zach-seletsky/ECE4180B-FinalProject/pictures/IMG_3392.jpeg

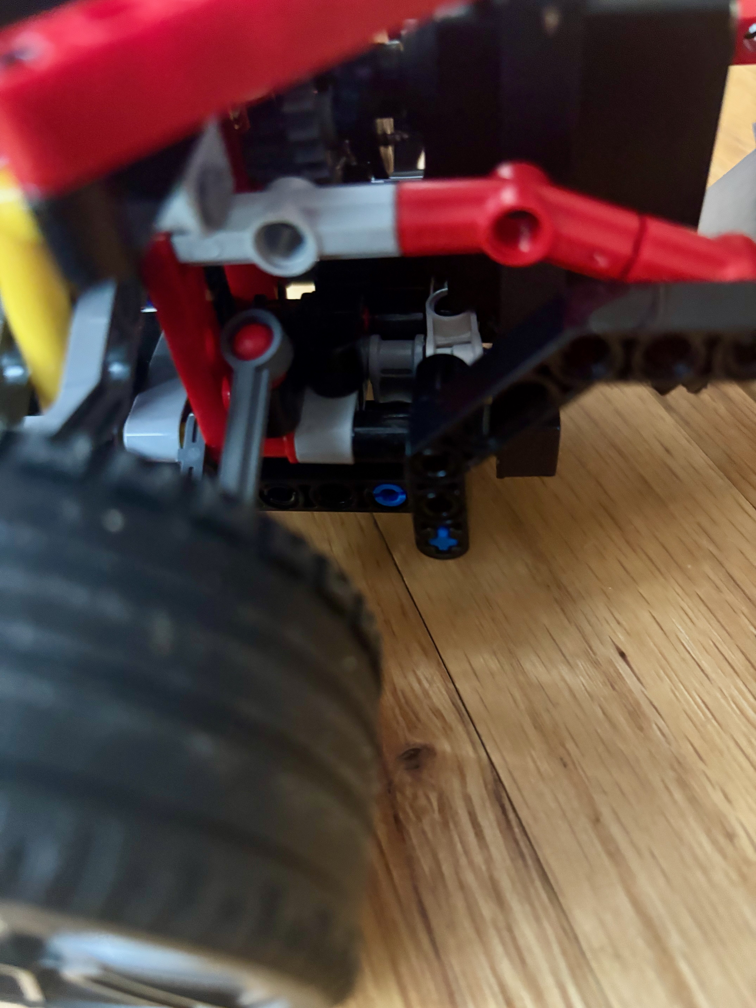
pictures/IMG_3392.jpeg
