zach-seletsky/ECE4180B-FinalProject/pictures/IMG_3384.jpeg

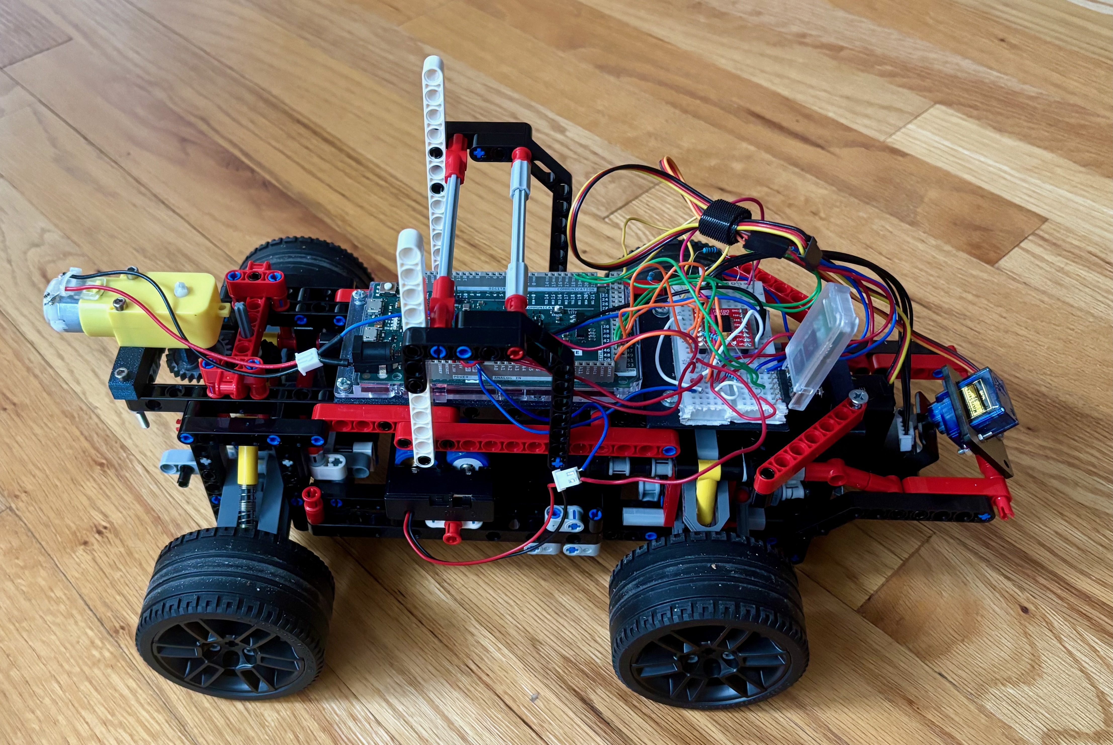
pictures/IMG_3384.jpeg
