zach-seletsky/ECE4180B-FinalProject/finalprojdiagram.png

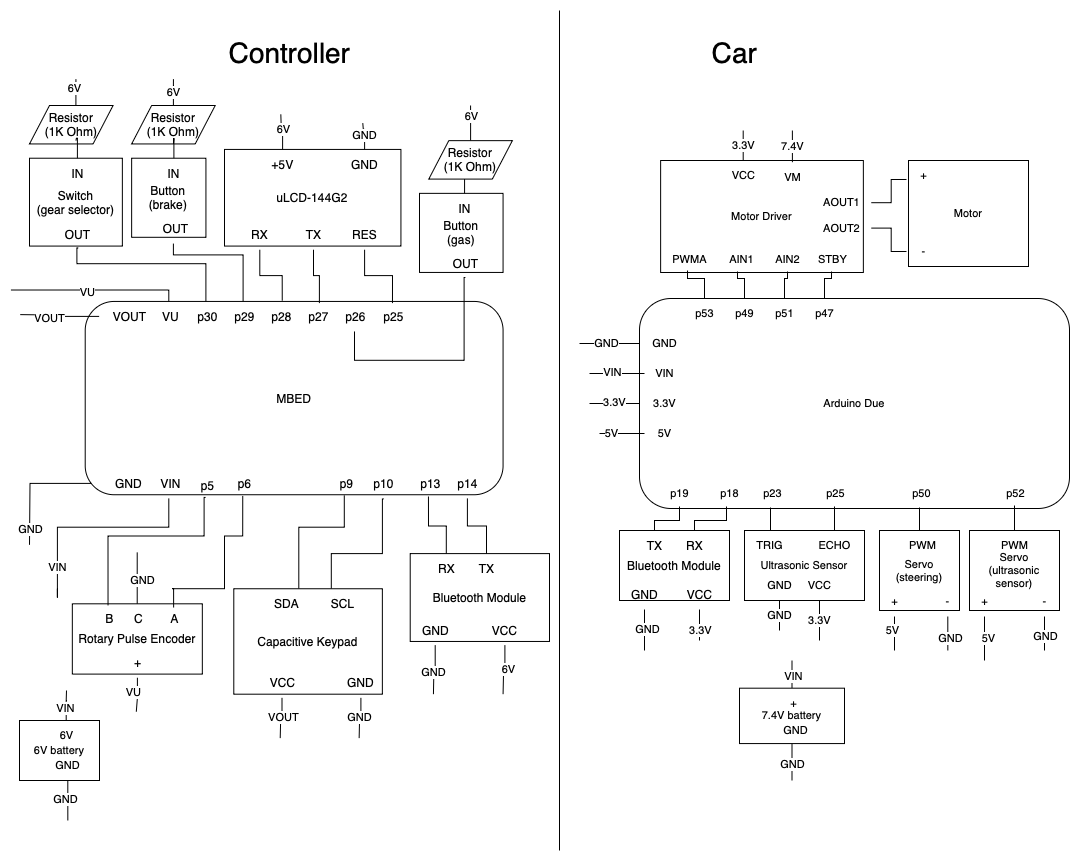
finalprojdiagram.png
