zach-seletsky/ECE4180B-FinalProject/pictures/IMG_3381.jpeg

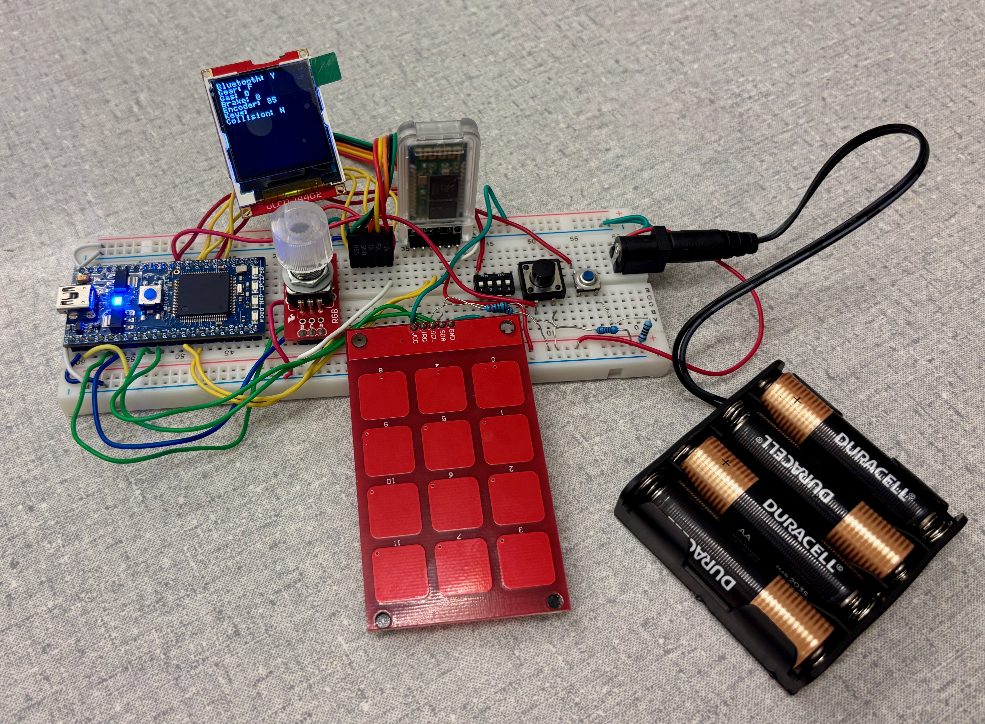
pictures/IMG_3381.jpeg
