zach-seletsky/ECE4180B-FinalProject/pictures/IMG_3385.jpeg

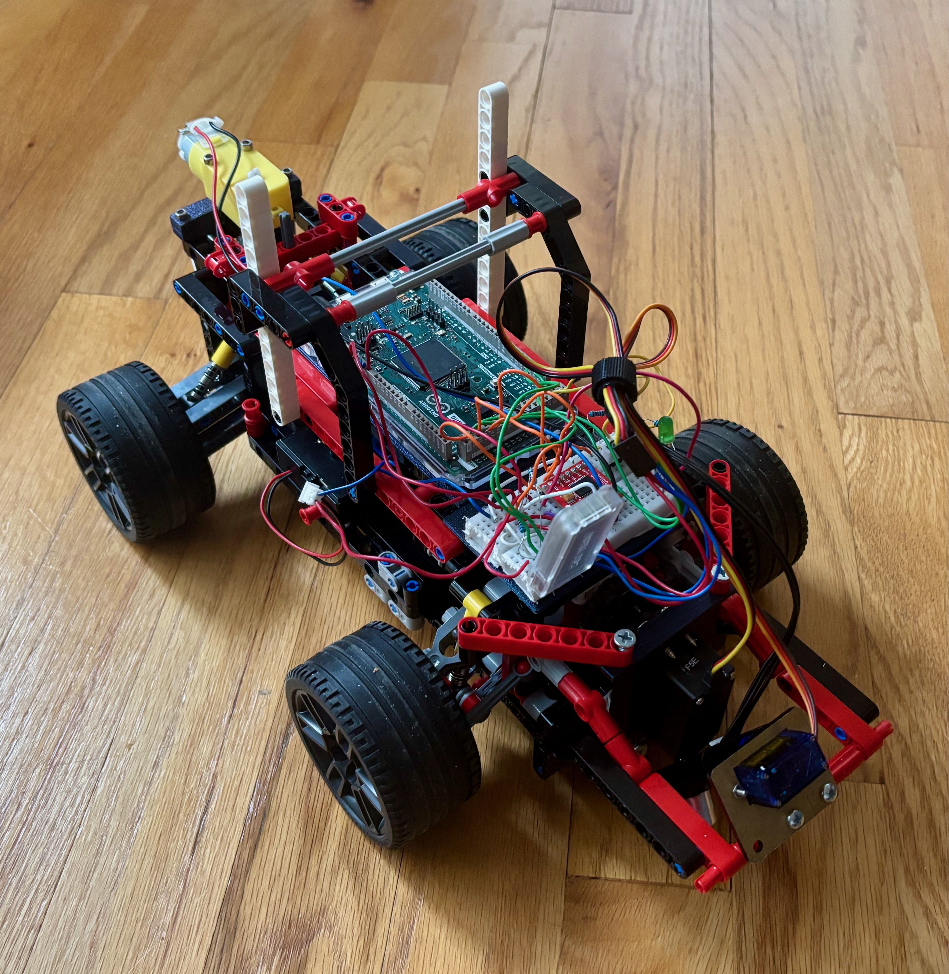
pictures/IMG_3385.jpeg
