zach-seletsky/ECE4180B-FinalProject/pictures/IMG_3386.jpeg

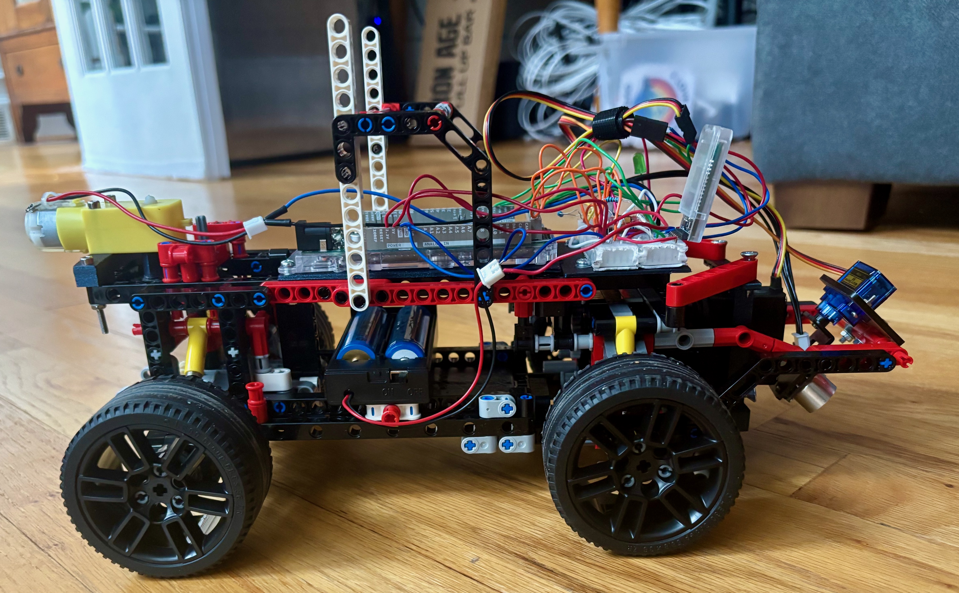
pictures/IMG_3386.jpeg
