zach-seletsky/ECE4180B-FinalProject/pictures/IMG_3388.jpeg

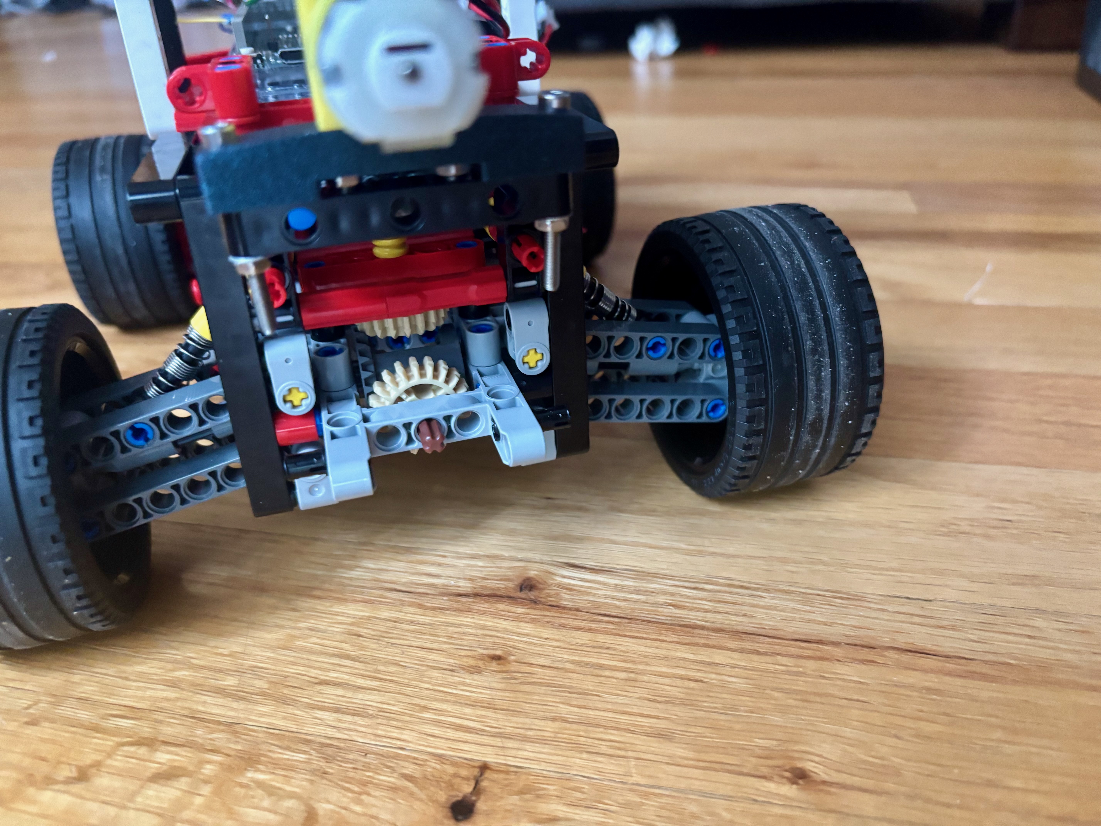
pictures/IMG_3388.jpeg
