zach-seletsky/ECE4180B-FinalProject/pictures/IMG_3389.jpeg

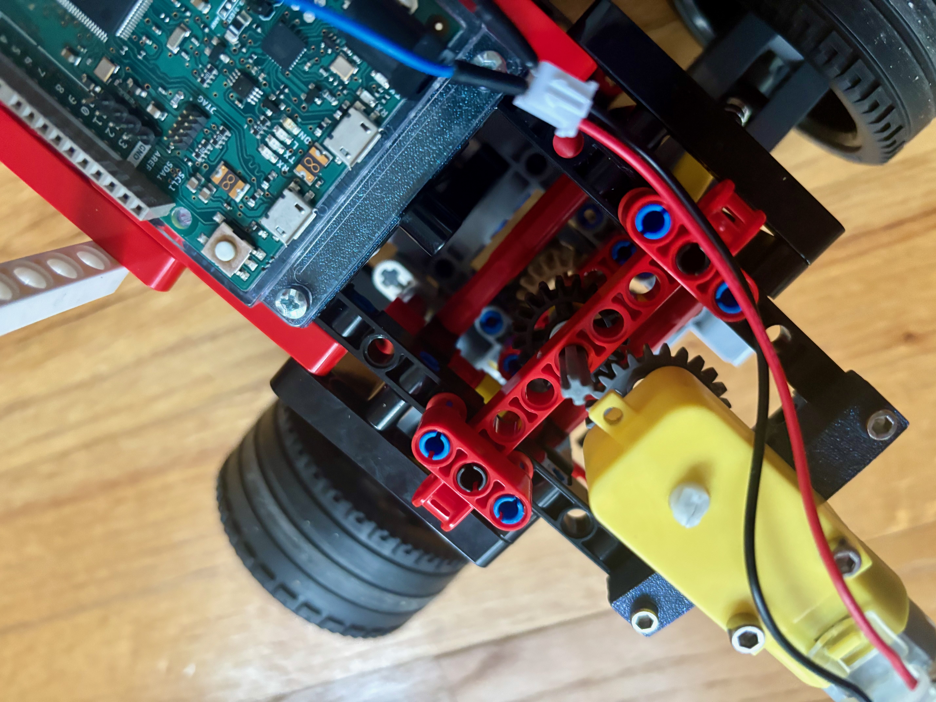
pictures/IMG_3389.jpeg
