zach-seletsky/ECE4180B-FinalProject/pictures/IMG_3390.jpeg

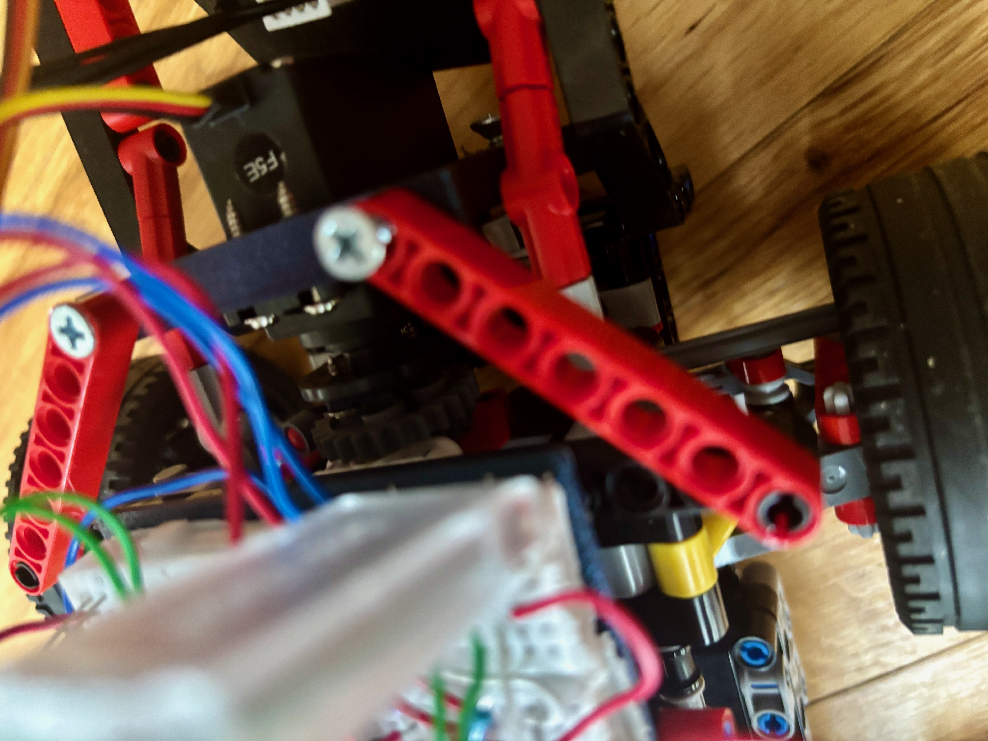
pictures/IMG_3390.jpeg
