zach-seletsky/ECE4180B-FinalProject/3D-prints/3mf-files/breadboard-mount-1.3mf

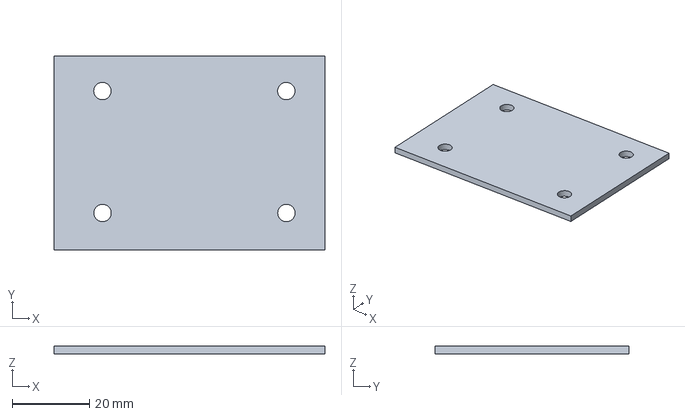
[picture p10: CAD file, 2025-04-19]
3D-prints/3mf-files/breadboard-mount-1.3mf
70.0 x 50.0 x 2.00 mm
