zach-seletsky/ECE4180B-FinalProject/3D-prints/3mf-files/due-mount-1.3mf

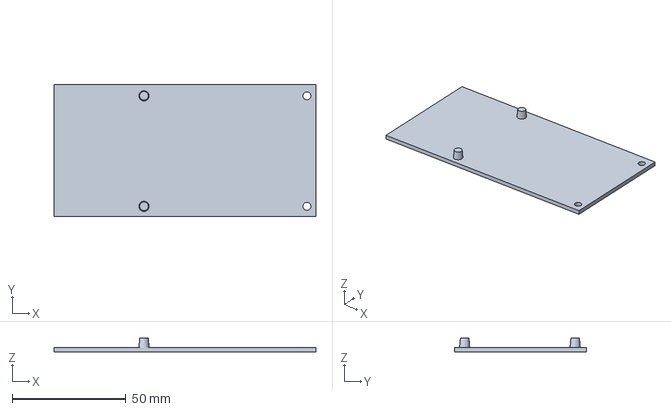
[picture p11: CAD file, 2025-04-19]
3D-prints/3mf-files/due-mount-1.3mf
115.0 x 58.0 x 6.00 mm
