zach-seletsky/ECE4180B-FinalProject/3D-prints/3mf-files/servo-lego-mount.3mf

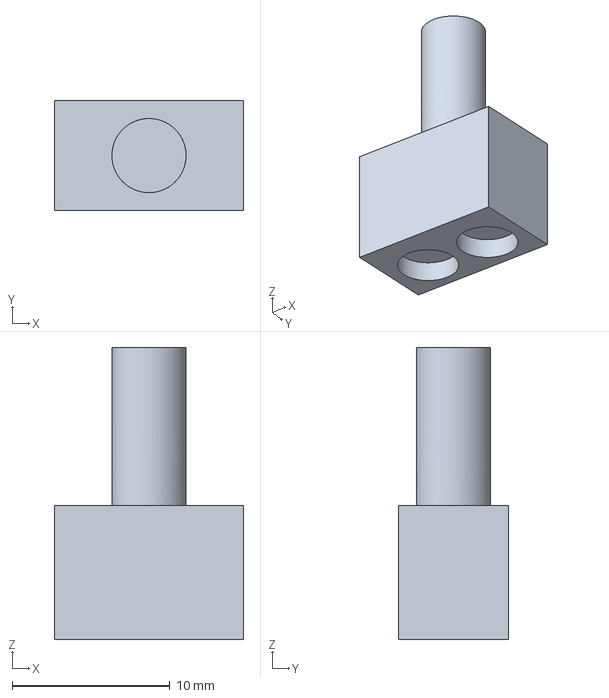
[picture p12: CAD file, 2025-04-19]
3D-prints/3mf-files/servo-lego-mount.3mf
12.0 x 6.99 x 18.5 mm
