zach-seletsky/ECE4180B-FinalProject/3D-prints/3mf-files/servo-mount-5.3mf

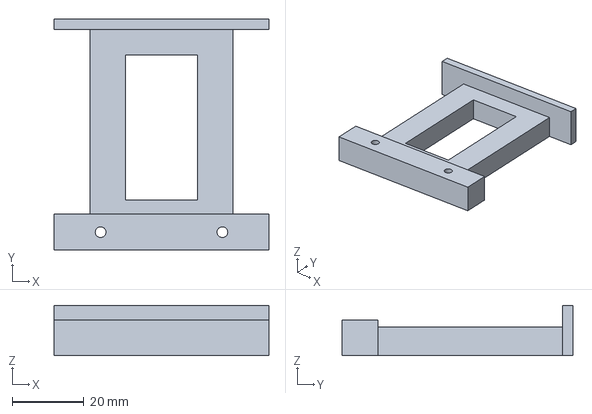
[picture p13: CAD file, 2025-04-19]
3D-prints/3mf-files/servo-mount-5.3mf
60.0 x 64.5 x 14.0 mm
