zach-seletsky/ECE4180B-FinalProject/3D-prints/3mf-files/motor-lego-adapter4.3mf

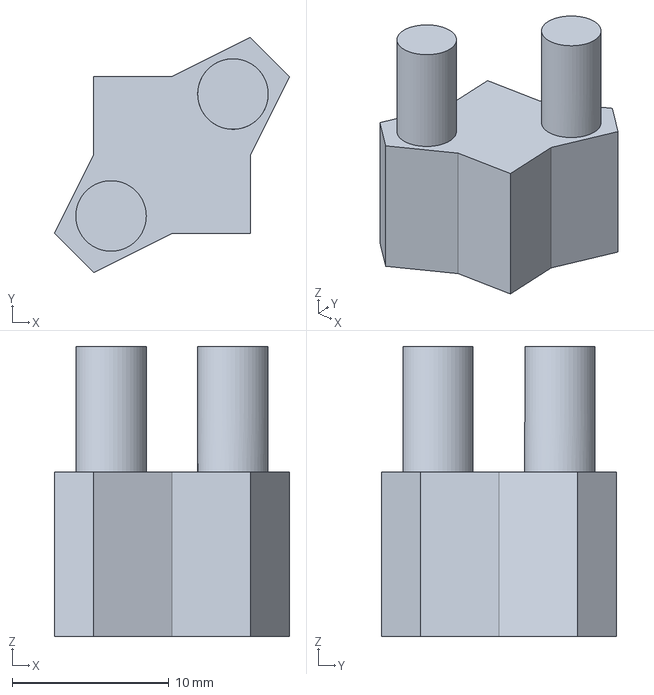
[picture p14: CAD file, 2025-04-19]
3D-prints/3mf-files/motor-lego-adapter4.3mf
15.0 x 15.0 x 18.5 mm
