zach-seletsky/ECE4180B-FinalProject/3D-prints/3mf-files/lego-insert-2.3mf

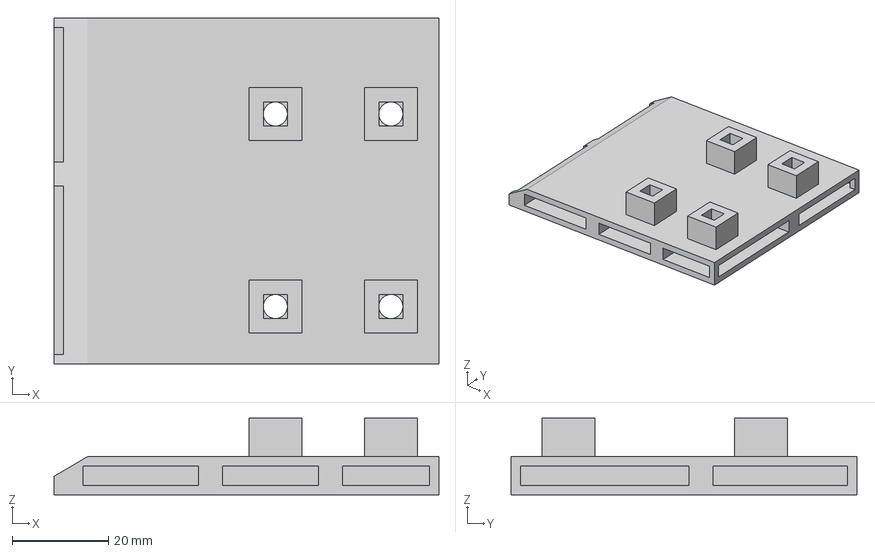
[picture p15: CAD file, 2025-04-19]
3D-prints/3mf-files/lego-insert-2.3mf
80.0 x 72.0 x 16.0 mm
