zach-seletsky/ECE4180B-FinalProject/3D-prints/3mf-files/servo-lego-adapter4.3mf

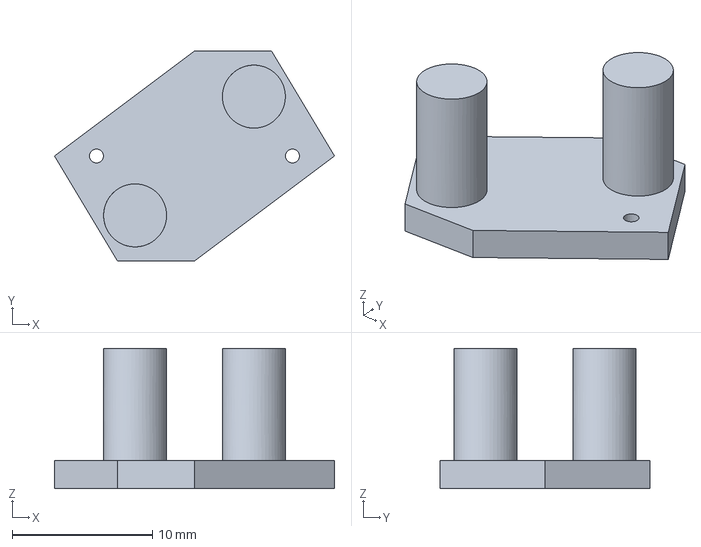
[picture p16: CAD file, 2025-04-19]
3D-prints/3mf-files/servo-lego-adapter4.3mf
20.0 x 15.0 x 10.0 mm
