zach-seletsky/ECE4180B-FinalProject/3D-prints/3mf-files/motor-mount-1.3mf

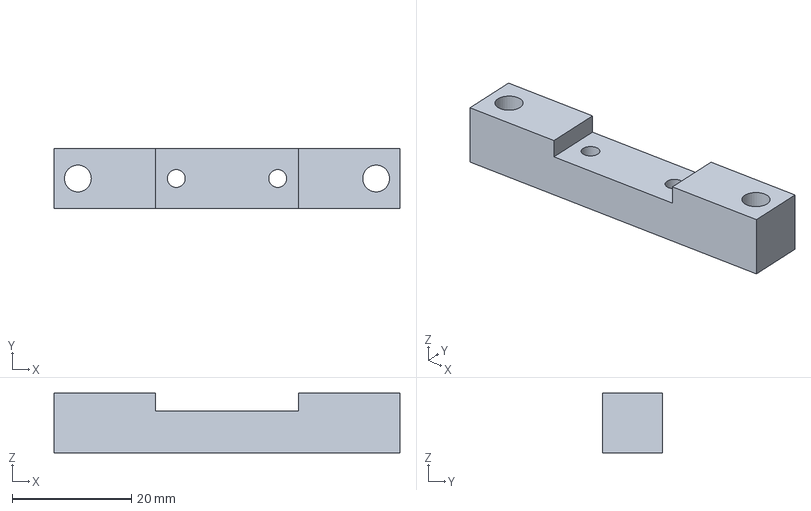
[picture p17: CAD file, 2025-04-19]
3D-prints/3mf-files/motor-mount-1.3mf
58.0 x 10.0 x 10.0 mm
