zach-seletsky/ECE4180B-FinalProject/3D-prints/Arduino-Due-Mount.png

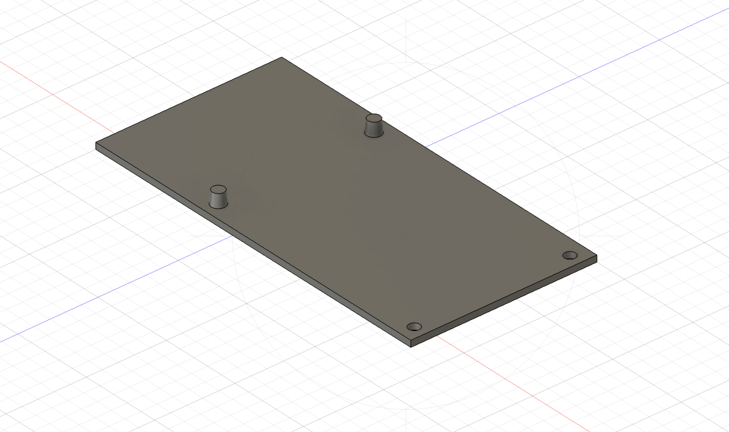
3D-prints/Arduino-Due-Mount.png
