zach-seletsky/ECE4180B-FinalProject/3D-prints/breadboard-mount.png

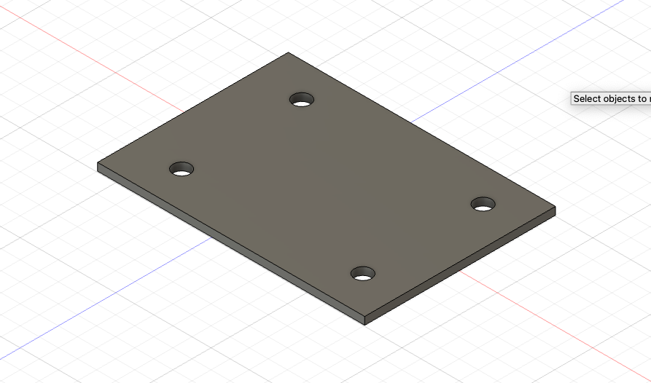
3D-prints/breadboard-mount.png
