zach-seletsky/ECE4180B-FinalProject/3D-prints/motor-legoGear-interface.png

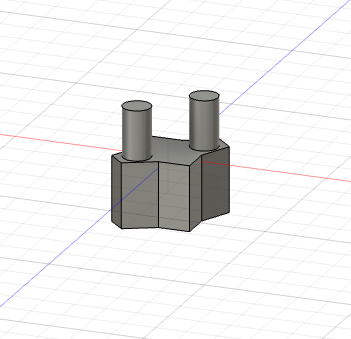
3D-prints/motor-legoGear-interface.png
