zach-seletsky/ECE4180B-FinalProject/3D-prints/motor-mount.png

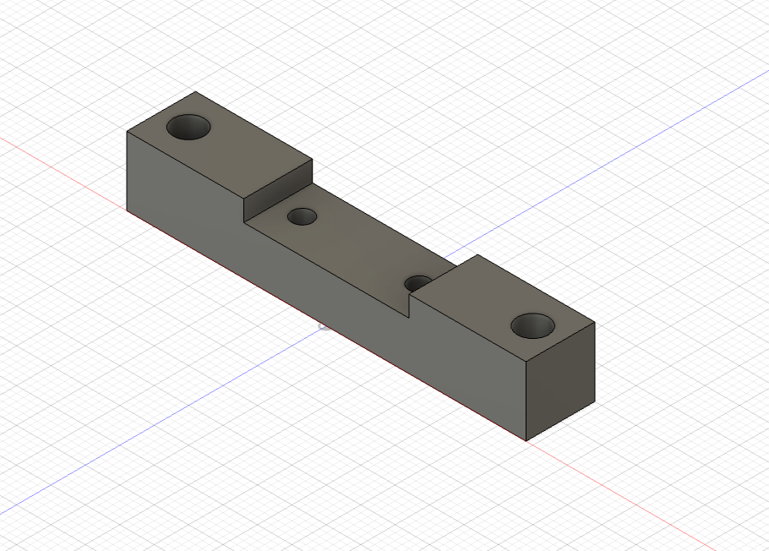
3D-prints/motor-mount.png
