zach-seletsky/ECE4180B-FinalProject/3D-prints/servo-legoGear-interface.png

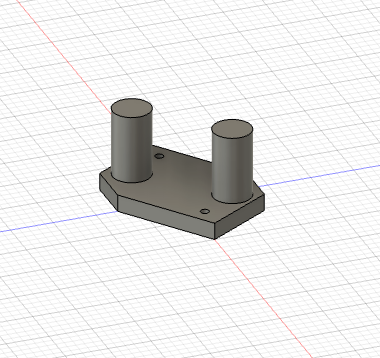
3D-prints/servo-legoGear-interface.png
