zach-seletsky/ECE4180B-FinalProject/3D-prints/servo-mount.png

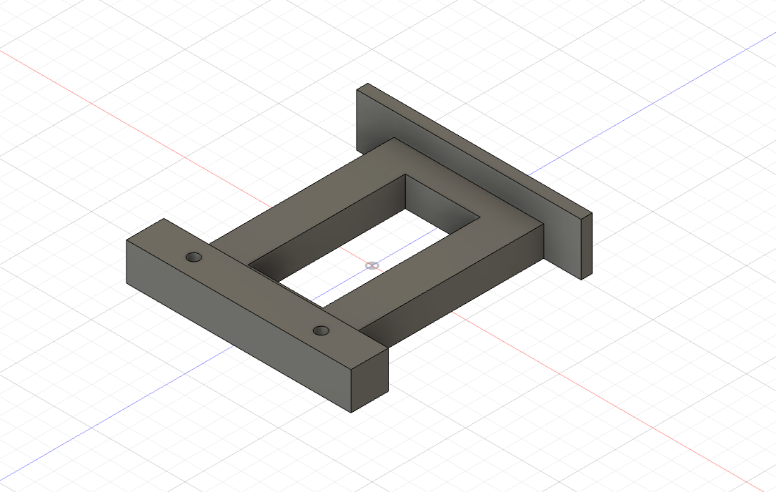
3D-prints/servo-mount.png
