zach-seletsky/ECE4180B-FinalProject/(commit log)

2025-04-19 Publishing Project
    [breadboard-mount-1.3mf, due-mount-1.3mf, lego-insert-2.3mf, motor-lego-adapter4.3mf, motor-mount-1.3mf, servo-lego-adapter4.3mf, servo-lego-mount.3mf, servo-mount-5.3mf]
2025-04-22 update readme- added pictures and screenshots
    [breadboard-mount-1.3mf, due-mount-1.3mf, lego-insert-2.3mf, motor-lego-adapter4.3mf, motor-mount-1.3mf, servo-lego-adapter4.3mf, servo-lego-mount.3mf, servo-mount-5.3mf]
